ryood/8thMFB/IMG_20201001_090948.jpg

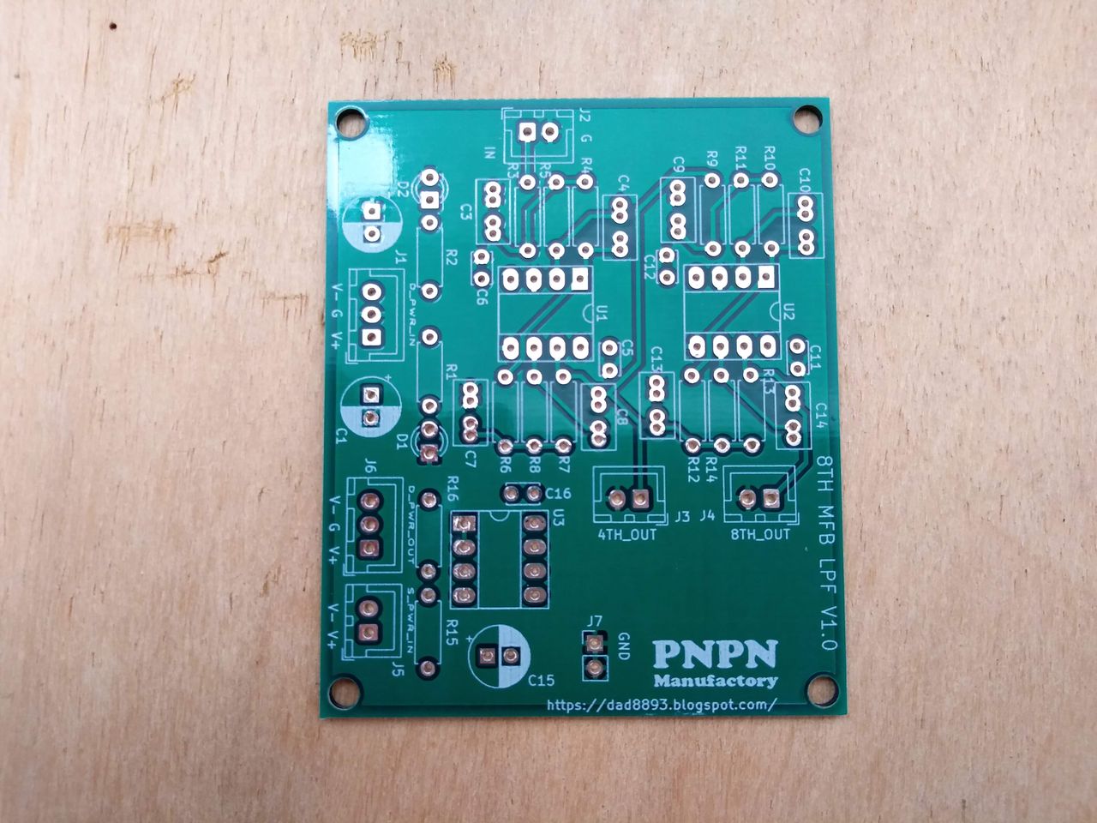
IMG_20201001_090948.jpg
