ryood/8thMFB/IMG_20201005_175604.jpg

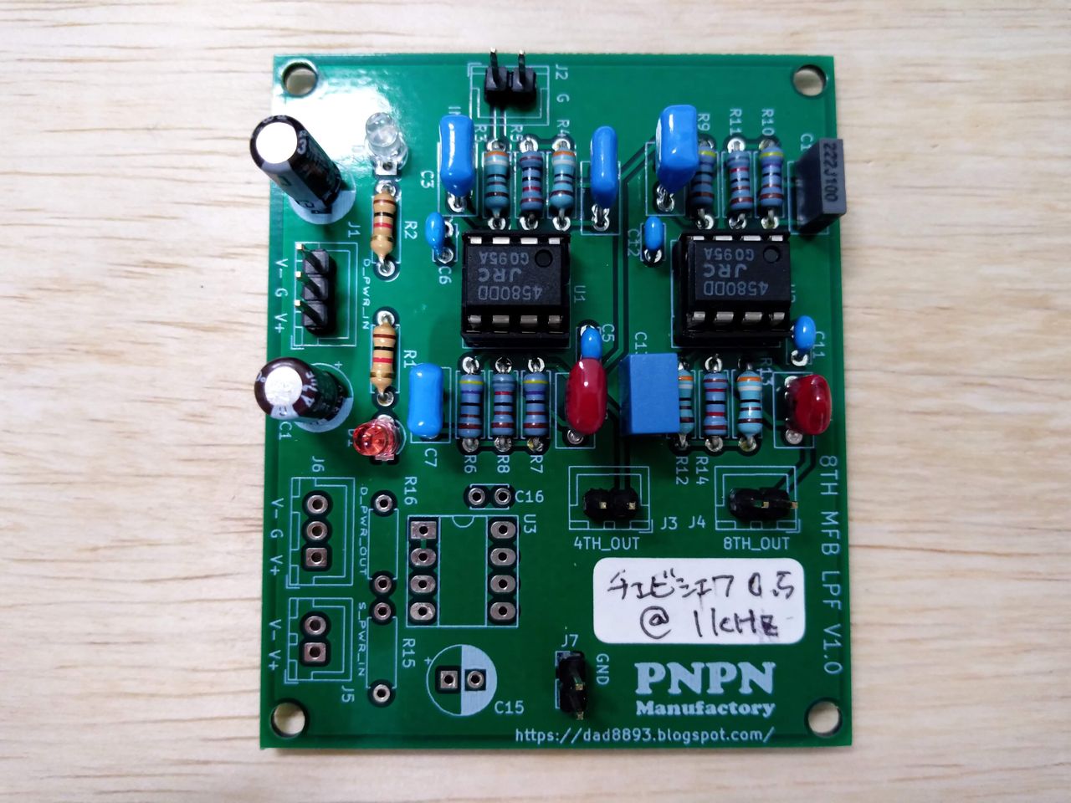
IMG_20201005_175604.jpg
