ryood/8thMFB/8thBesselLPF_MFB.PNG

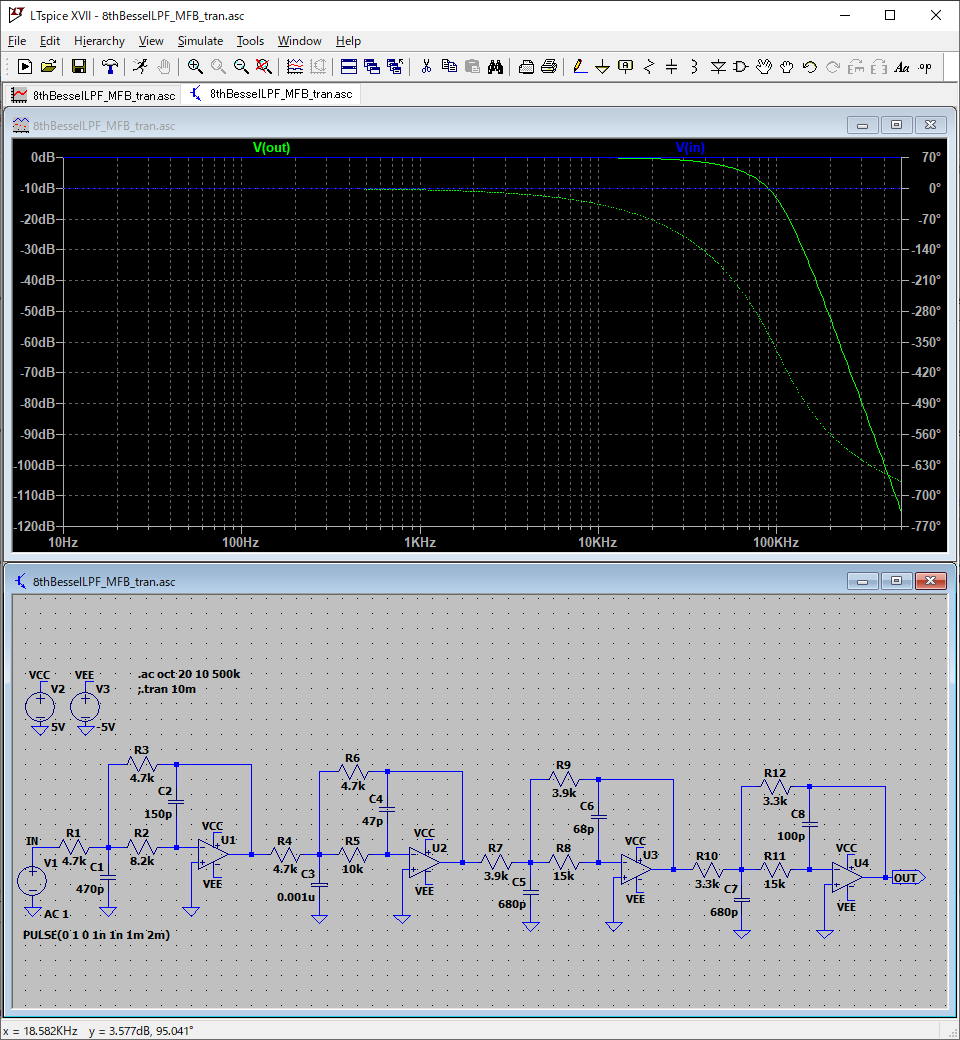
8thBesselLPF_MFB.PNG
