ryood/8thMFB/Bessel_1kHz_ac.png

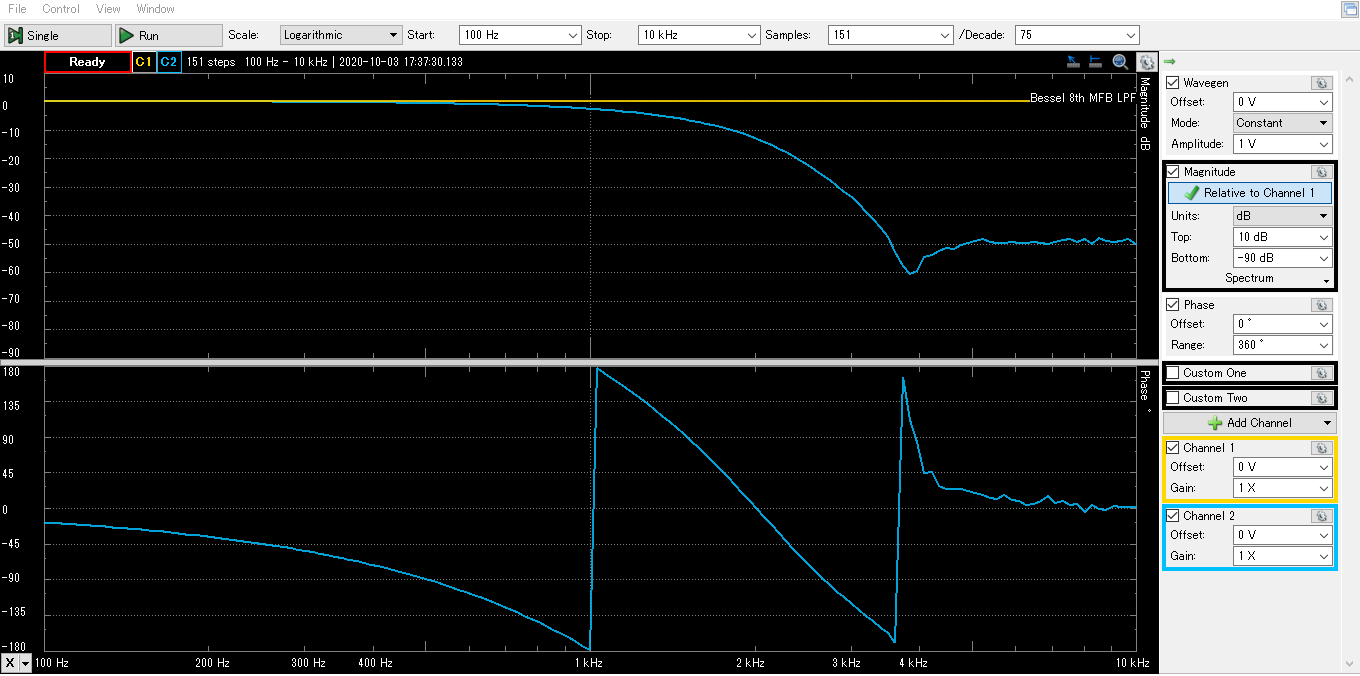
Bessel_1kHz_ac.png
