ryood/8thMFB/Bessel_1kHz_cutoff.png

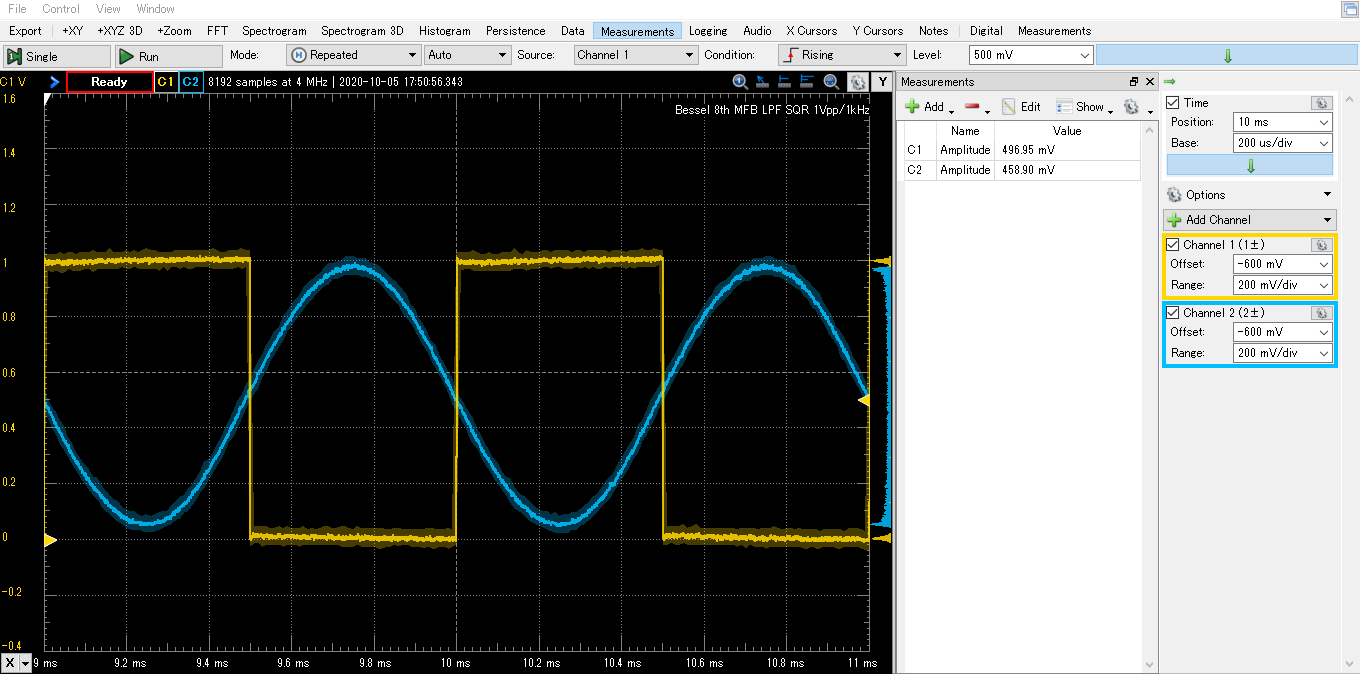
Bessel_1kHz_cutoff.png
