ryood/8thMFB/Bessel_1kHz_saw.png

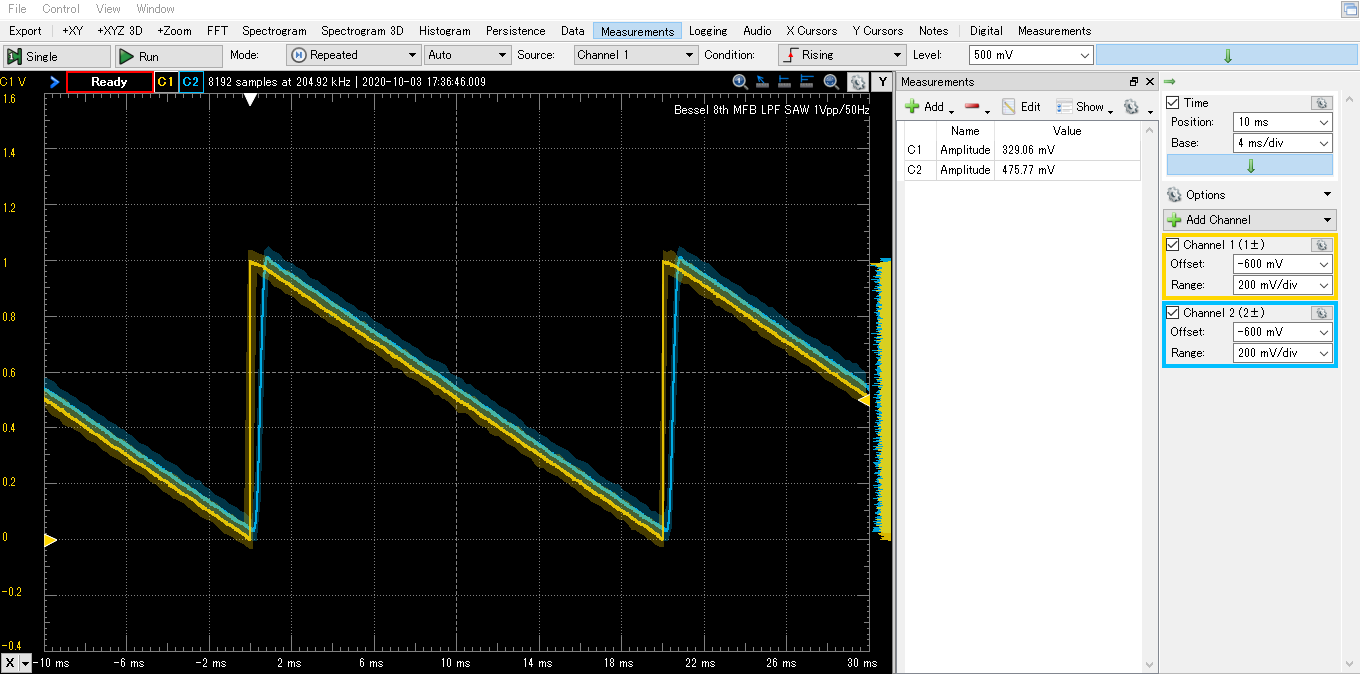
Bessel_1kHz_saw.png
