ryood/8thMFB/Butterworth_1kHz_ac.png

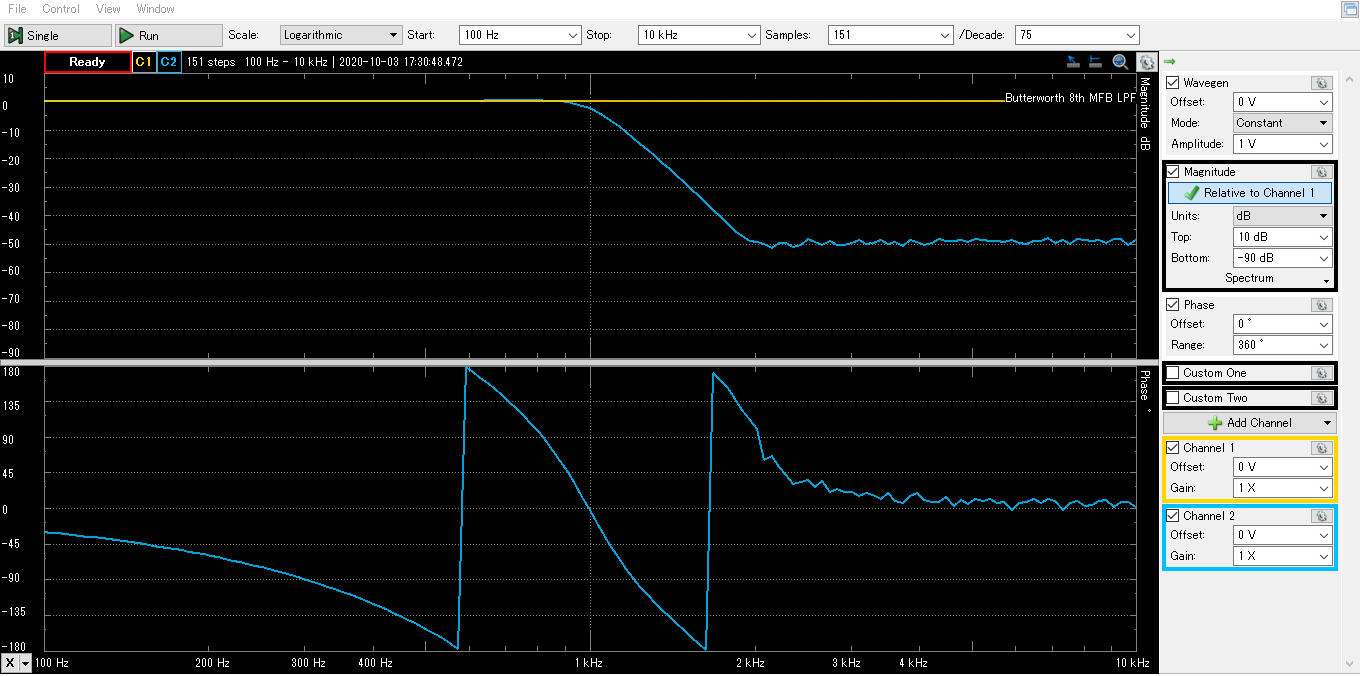
Butterworth_1kHz_ac.png
