ryood/8thMFB/Butterworth_1kHz_cutoff.png

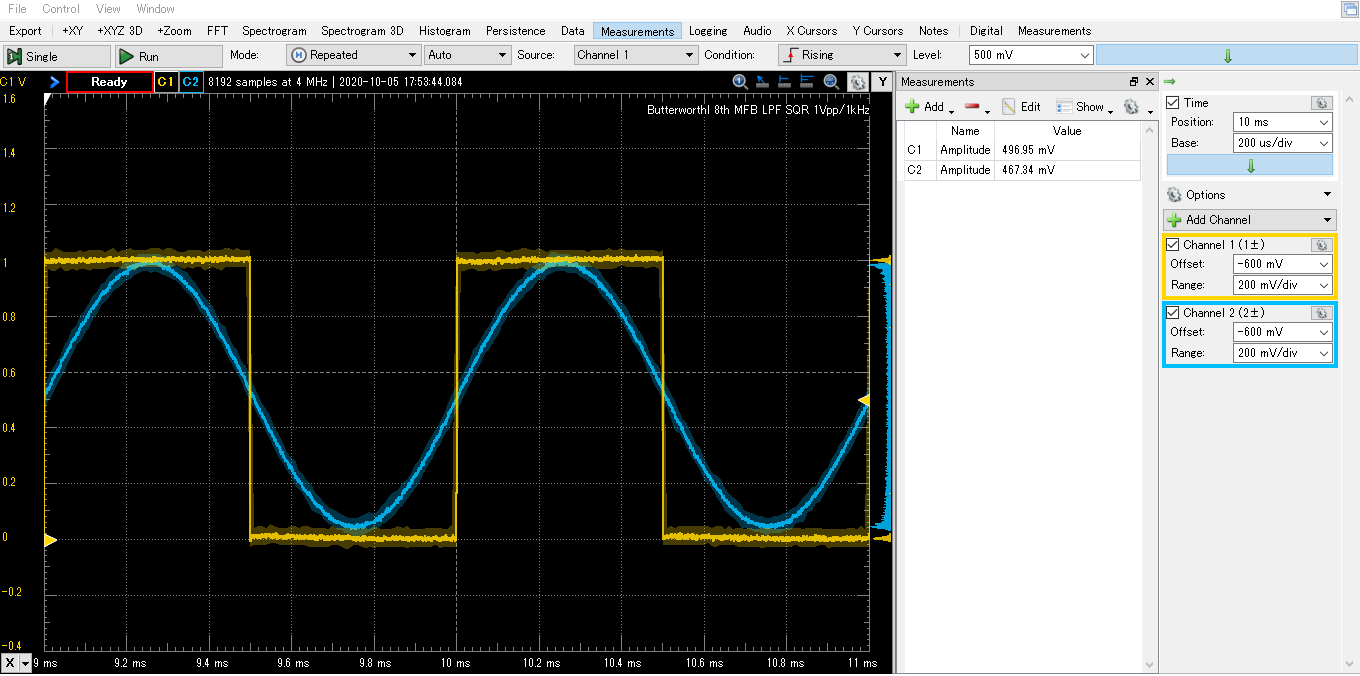
Butterworth_1kHz_cutoff.png
