ryood/8thMFB/Chebyshev_0_5dB_1kHz_ac.png

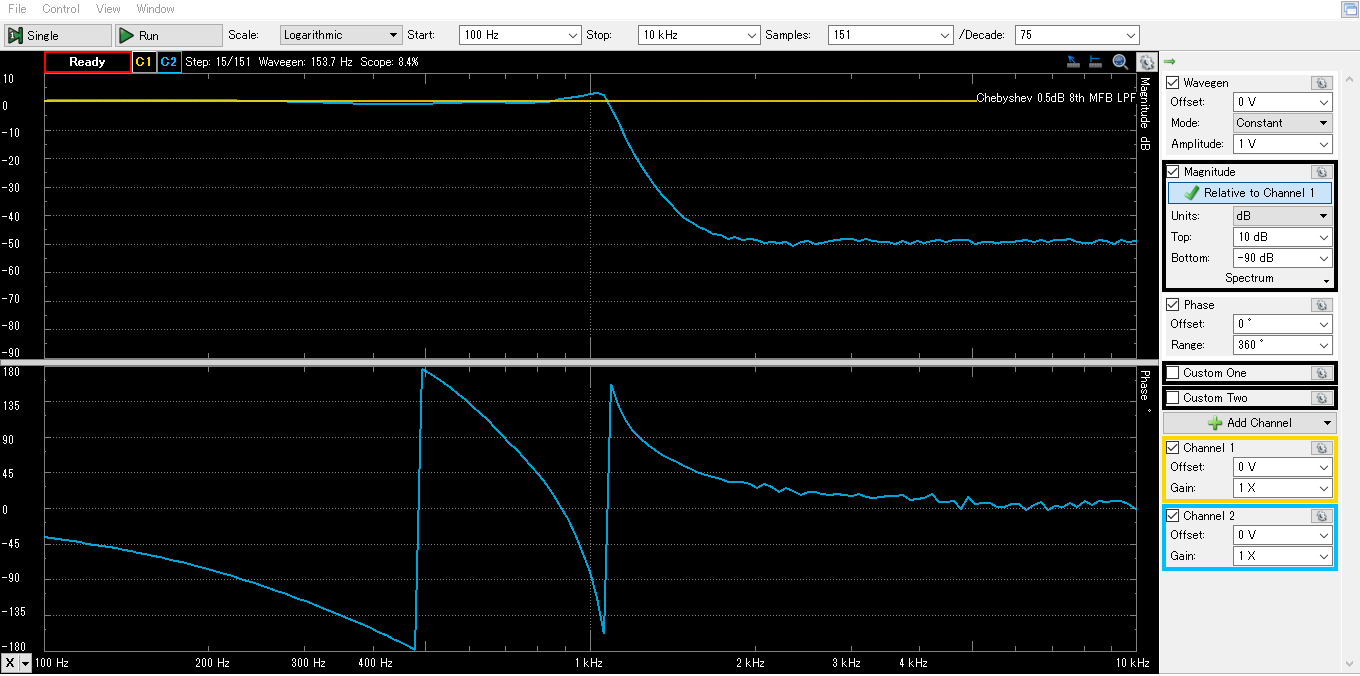
Chebyshev_0_5dB_1kHz_ac.png
