ryood/8thMFB/General_8th_MFB_LPF_sch_Draft.jpg

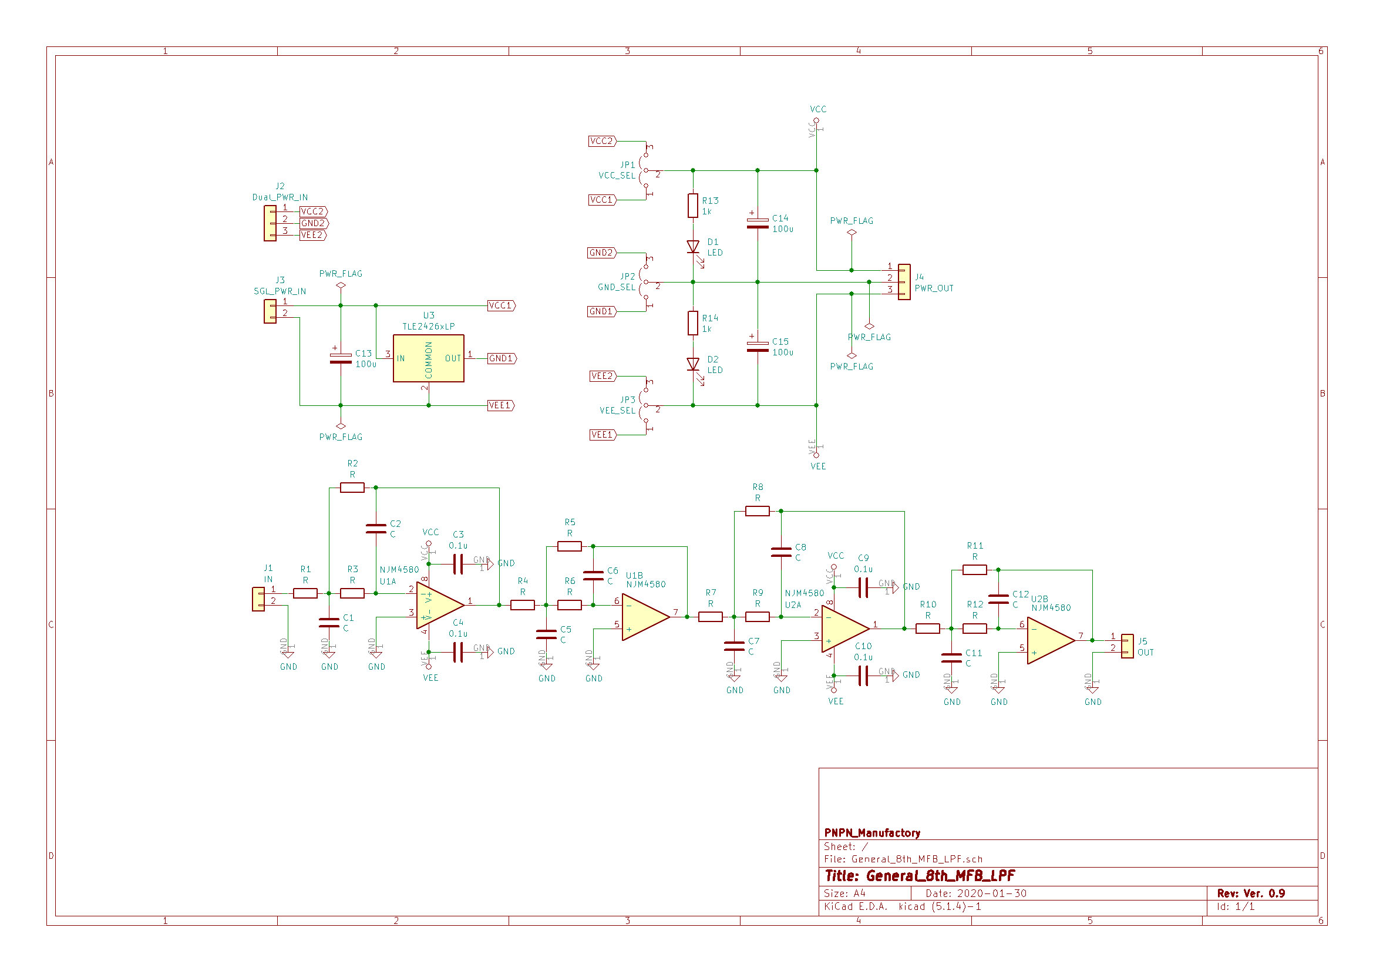
General_8th_MFB_LPF_sch_Draft.jpg
