ryood/8thMFB/IMG_20201001_091002.jpg

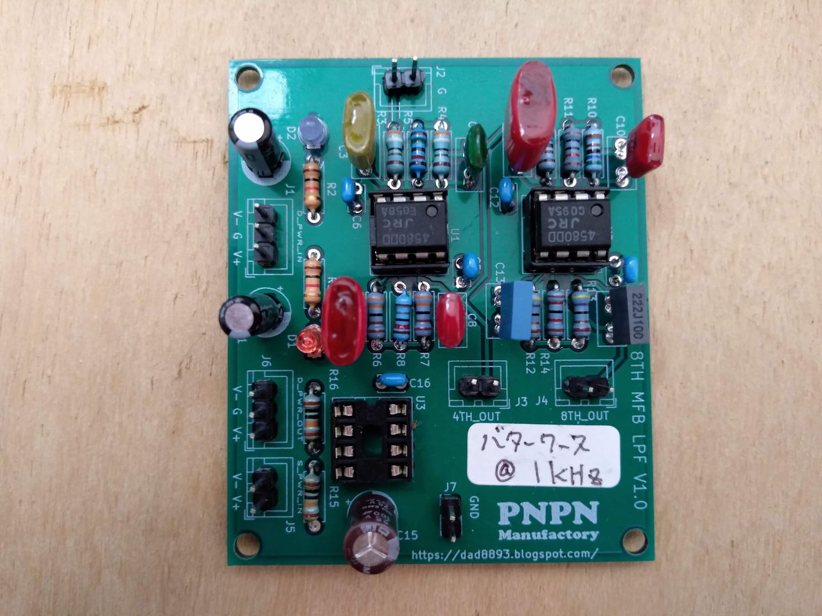
IMG_20201001_091002.jpg
