ryood/8thMFB/IMG_20201001_091025.jpg

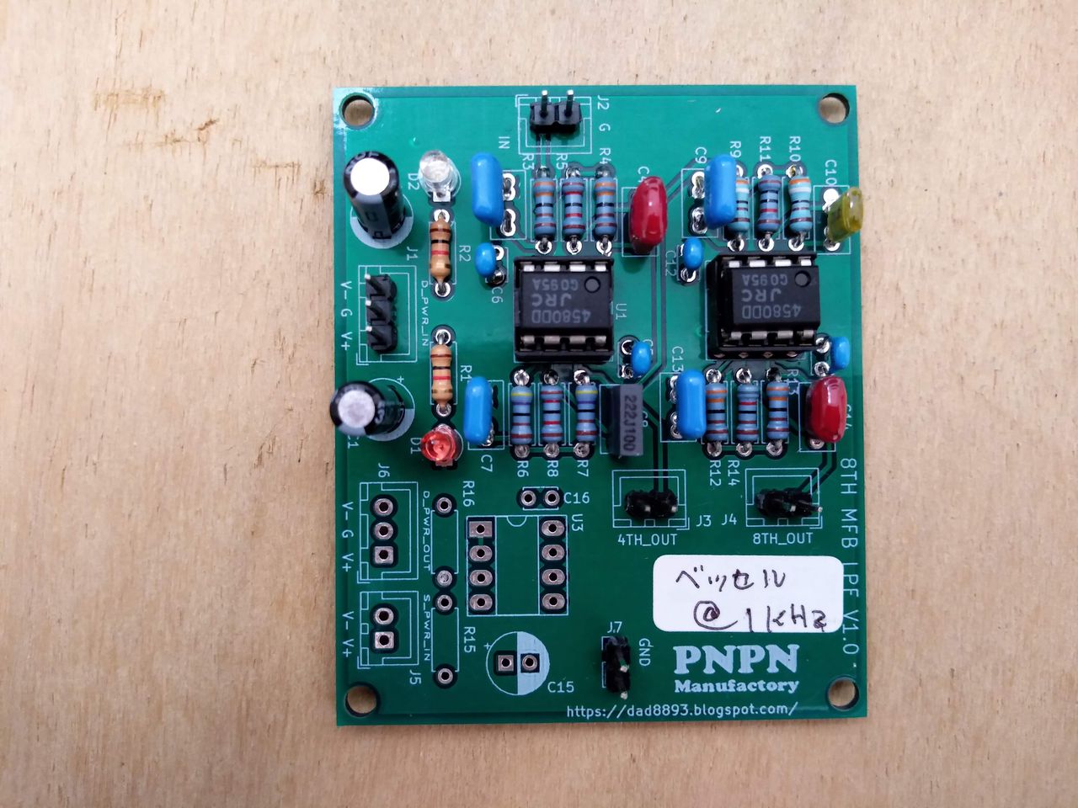
IMG_20201001_091025.jpg
