ryood/8thMFB/KiCAD/General_8th_MFB_LPF_brd.png

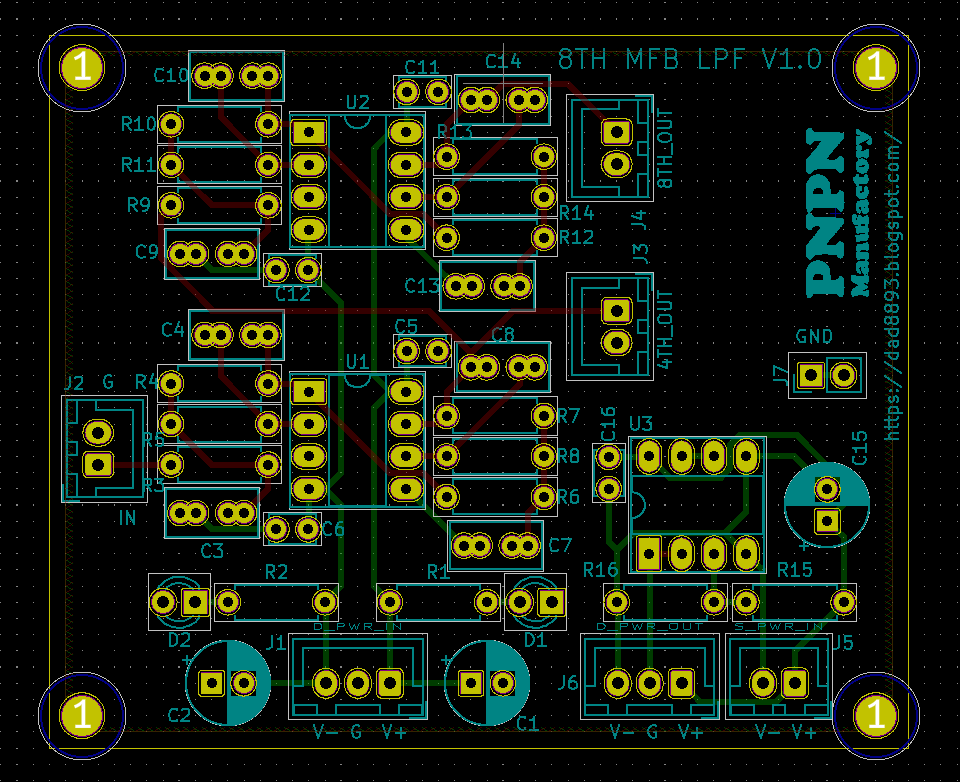
KiCAD/General_8th_MFB_LPF_brd.png
