ryood/8thMFB/spice/1kHz/8th_MFB_LPF_Bessel_1kHz_sch.png

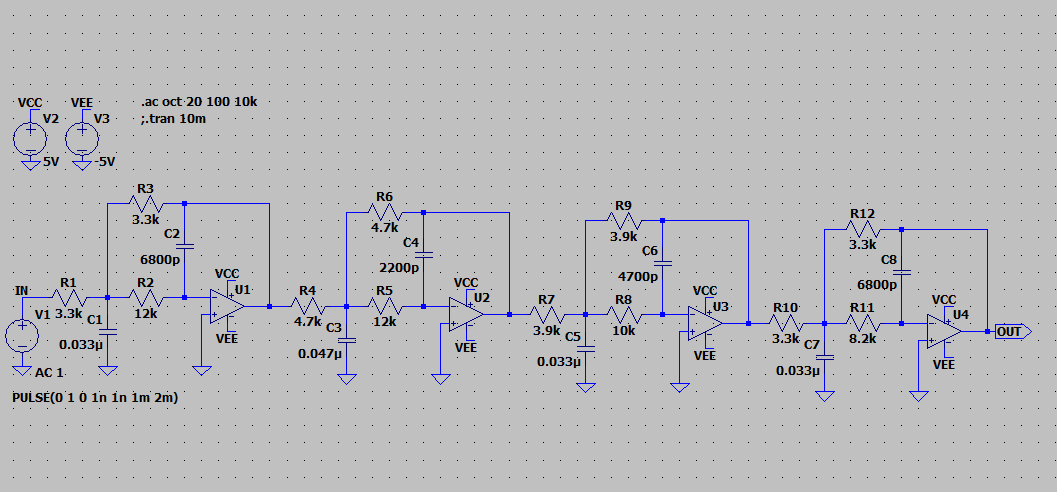
spice/1kHz/8th_MFB_LPF_Bessel_1kHz_sch.png
