ryood/8thMFB/spice/1kHz/8th_MFB_LPF_Chebyshev_0_5dB_1kHz_ac.png

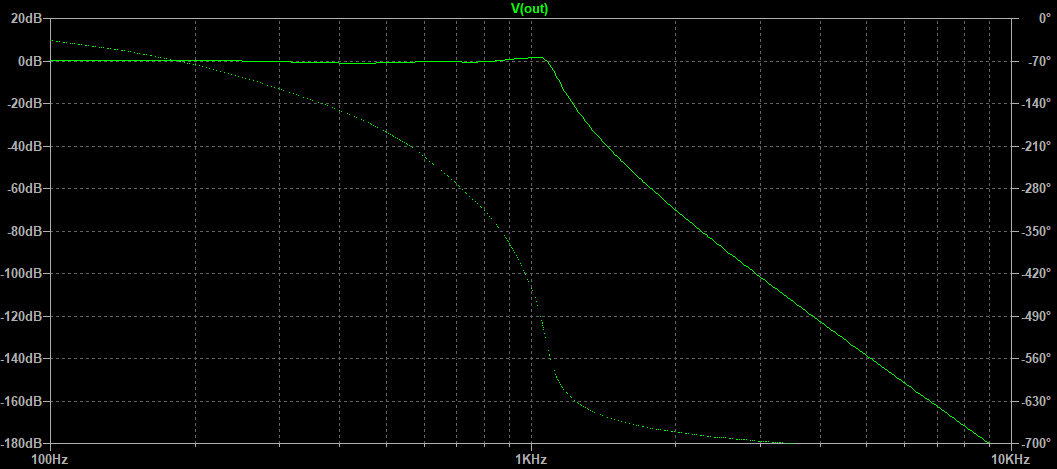
spice/1kHz/8th_MFB_LPF_Chebyshev_0_5dB_1kHz_ac.png
