ryood/8thMFB/Bessel_1kHz_step.png

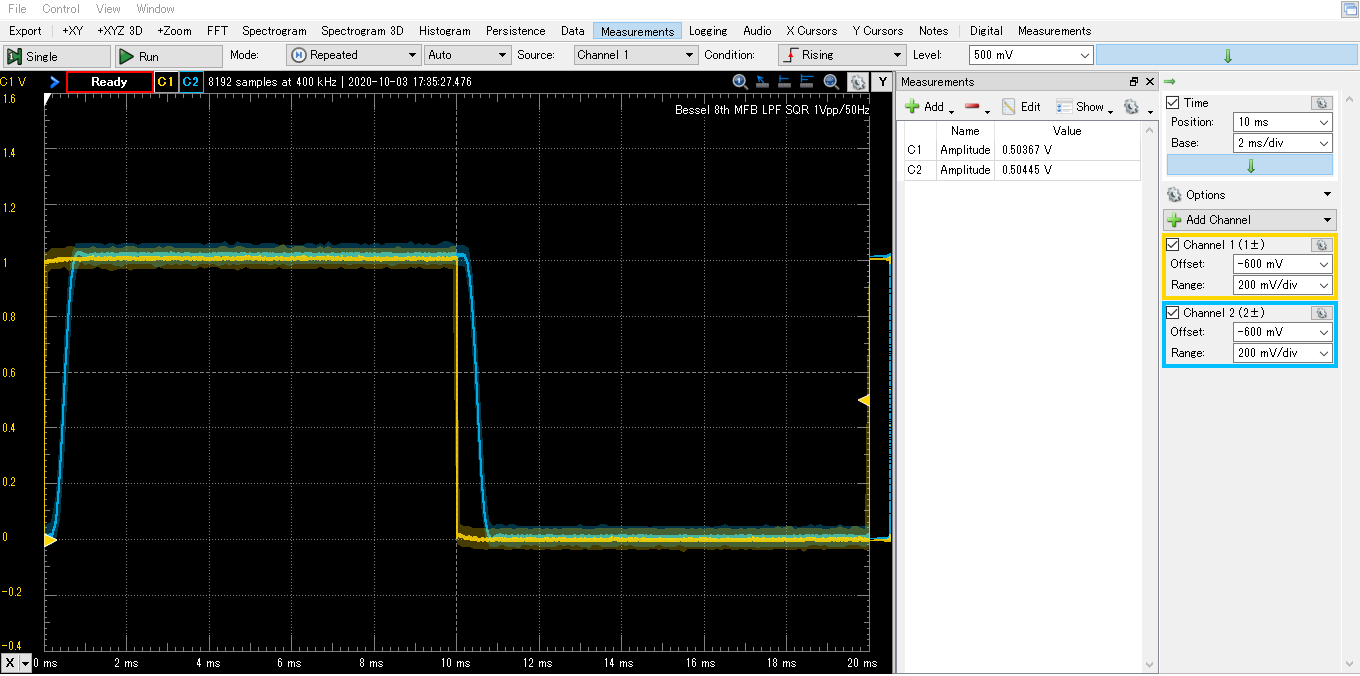
Bessel_1kHz_step.png
