ryood/8thMFB/spice/1kHz/8th_MFB_LPF_Bessel_1kHz_step.png

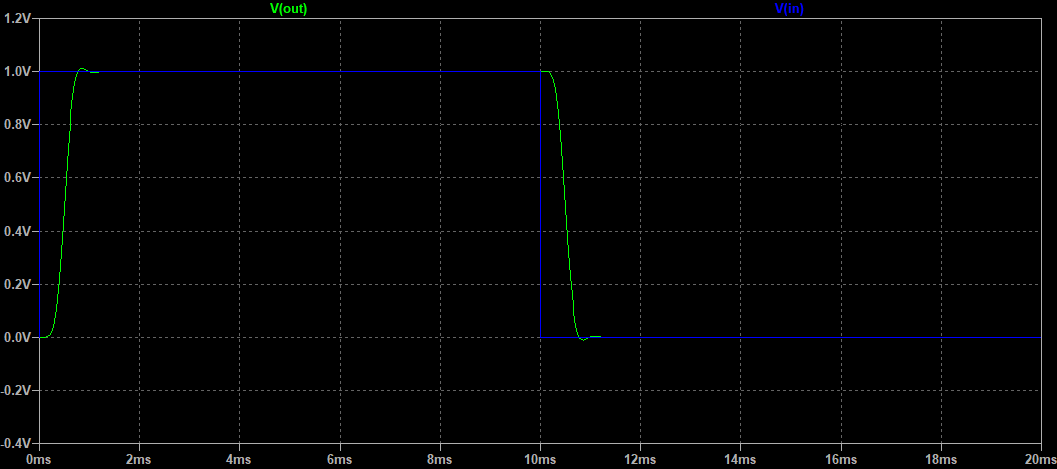
spice/1kHz/8th_MFB_LPF_Bessel_1kHz_step.png
