ryood/8thMFB/spice/Test/8th_bessel_48k_ac.png

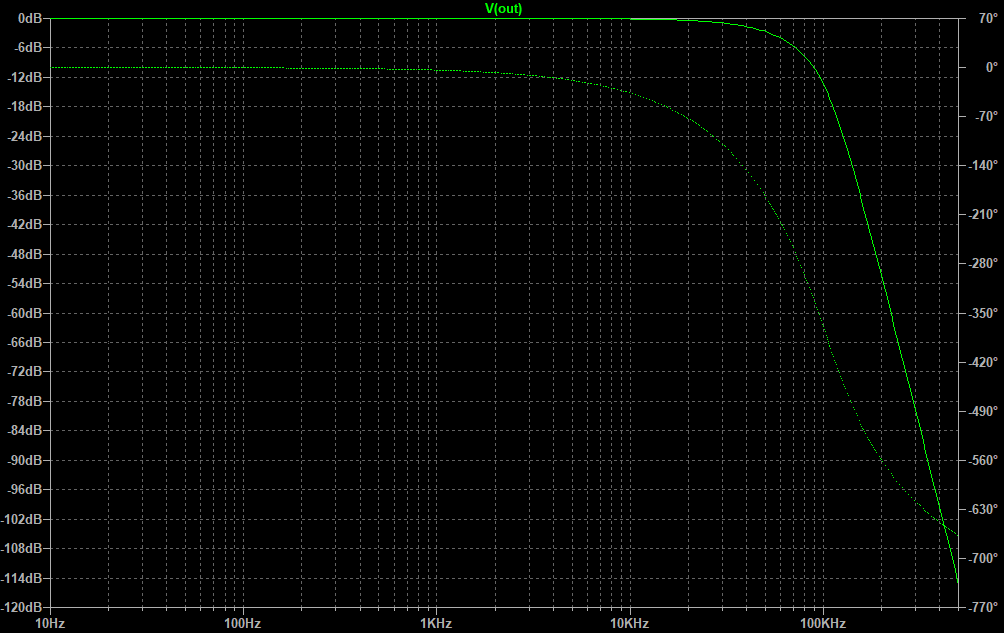
spice/Test/8th_bessel_48k_ac.png
