ryood/8thMFB/spice/1kHz/8th_MFB_LPF_ButterWorth_1kHz_step.asc

C1: cap; 0.047µ
C2: cap; 0.01µ
C3: cap; 0.068µ
C4: cap; 6800p
C5: cap; 0.068µ
C6: cap; 6800p
C7: cap; 0.22µ
C8: cap; 2200p
R1: res; 3.9k
R2: res; 15k
R3: res; 3.9k
R4: res; 3.3k
R5: res; 18k
R6: res; 3.3k
R7: res; 5.6k
R8: res; 10k
R9: res; 5.6k
R10: res; 4.7k
R11: res; 12k
R12: res; 4.7k
U1: UniversalOpamp2
U2: UniversalOpamp2
U3: UniversalOpamp2
U4: UniversalOpamp2
V1: voltage; PULSE(0 1 0 1n 1n 10m 20m); AC 1
V2: voltage; 5V
V3: voltage; -5V
Named nets: VCC, VEE, 0, OUT, IN
;.ac oct 20 10 500k
.tran 20m
