ryood/8thMFB/spice/1kHz/8th_MFB_LPF_Chebyshev_0_5dB_1kHz_step.asc

C1: cap; 0.22µ
C2: cap; 0.033µ
C3: cap; 0.22µ
C4: cap; 6800p
C5: cap; 0.33µ
C6: cap; 2200p
C7: cap; 1µ
C8: cap; 470p
R1: res; 3.9k
R2: res; 10k
R3: res; 3.9k
R4: res; 4.7k
R5: res; 8.2k
R6: res; 4.7k
R7: res; 4.7k
R8: res; 8.2k
R9: res; 4.7k
R10: res; 3.9k
R11: res; 12k
R12: res; 3.9k
U1: UniversalOpamp2
U2: UniversalOpamp2
U3: UniversalOpamp2
U4: UniversalOpamp2
V1: voltage; PULSE(0 1 0 1n 1n 10m 20m); AC 1
V2: voltage; 5V
V3: voltage; -5V
Named nets: VCC, VEE, 0, OUT, IN
;.ac oct 20 10 500k
.tran 20m
