ryood/8thMFB/spice/Test/8thBesselLPF_MFB_ac.asc

C1: cap; 470p
C2: cap; 150p
C3: cap; 0.001u
C4: cap; 47p
C5: cap; 680p
C6: cap; 68p
C7: cap; 680p
C8: cap; 100p
R1: res; 4.7k
R2: res; 8.2k
R3: res; 4.7k
R4: res; 4.7k
R5: res; 10k
R6: res; 4.7k
R7: res; 3.9k
R8: res; 15k
R9: res; 3.9k
R10: res; 3.3k
R11: res; 15k
R12: res; 3.3k
U1: UniversalOpamp2
U2: UniversalOpamp2
U3: UniversalOpamp2
U4: UniversalOpamp2
V1: voltage; PULSE(0 1 0 1n 1n 1m 2m); AC 1
V2: voltage; 5V
V3: voltage; -5V
Named nets: VCC, VEE, 0, OUT, IN
.ac oct 20 10 500k
;.tran 10m
