ryood/8thMFB/spice/Test/8thButterWorthLPF_MFB.asc

C1: cap; 470p
C2: cap; 100p
C3: cap; 680p
C4: cap; 100p
C5: cap; 680p
C6: cap; 68p
C7: cap; 0.0022u
C8: cap; 22p
R1: res; 3.9k
R2: res; 15k
R3: res; 3.9k
R4: res; 3.3k
R5: res; 12k
R6: res; 3.3k
R7: res; 5.6k
R8: res; 10k
R9: res; 5.6k
R10: res; 4.7k
R11: res; 12k
R12: res; 4.7k
U1: UniversalOpamp2
U2: UniversalOpamp2
U3: UniversalOpamp2
U4: UniversalOpamp2
V1: voltage; PULSE(-0.5 0.5 0 100u 0 0 100u); AC 1
V2: voltage; 5V
V3: voltage; -5V
Named nets: VCC, VEE, 0, OUT, IN
;ac oct 20 10 500k
.tran 300us
