ryood/8thMFB/spice/Test/9thBesselLPF_MFB.asc

C1: cap; 470p
C2: cap; 150p
C3: cap; 680p
C4: cap; 100p
C5: cap; 680p
C6: cap; 100p
C7: cap; 0.001u
C8: cap; 47p
C9: cap; 0.01u
R1: res; 4.7k
R2: res; 8.2k
R3: res; 4.7k
R4: res; 3.3k
R5: res; 12k
R6: res; 3.3k
R7: res; 3.9k
R8: res; 12k
R9: res; 3.9k
R10: res; 4.7k
R11: res; 8.2k
R12: res; 4.7k
R13: res; 180
U1: UniversalOpamp2
U2: UniversalOpamp2
U3: UniversalOpamp2
U4: UniversalOpamp2
U5: UniversalOpamp2
V1: voltage; PULSE(-0.5 0.5 0 100u 1n 0 100u); AC 1
V2: voltage; 5V
V3: voltage; -5V
Named nets: VCC, VEE, 0, OUT, IN
.ac oct 20 10 500k
;.tran 300u
