ryood/8thMFB/spice/Test/PCM5102A_FG_RLC_4thLPF.asc

C1: cap; 0.033uF
C2: cap; 0.022uF
C3: cap; 8200pF
L1: ind; 4.7uH
L2: ind; 68uH
L3: ind; 2.2uH
R1: res; 50
R2: res; 50
V1: voltage; PULSE(-0.5 0.5 0 100u 0 0 100u); AC 1
Named nets: 0, OUT
.ac oct 20 10 1Meg
;tran 0 10m 9.7m
