ryood/8thMFB/(list of files, drawings)

Other design files:
fritzing/8th_MFB.fzz
