ryood/8thMFB/KiCAD/General_8th_MFB_LPF/General_8th_MFB_LPF.kicad_pcb

## KiCad design KiCAD/General_8th_MFB_LPF/General_8th_MFB_LPF.kicad_pcb (2020-10-05)

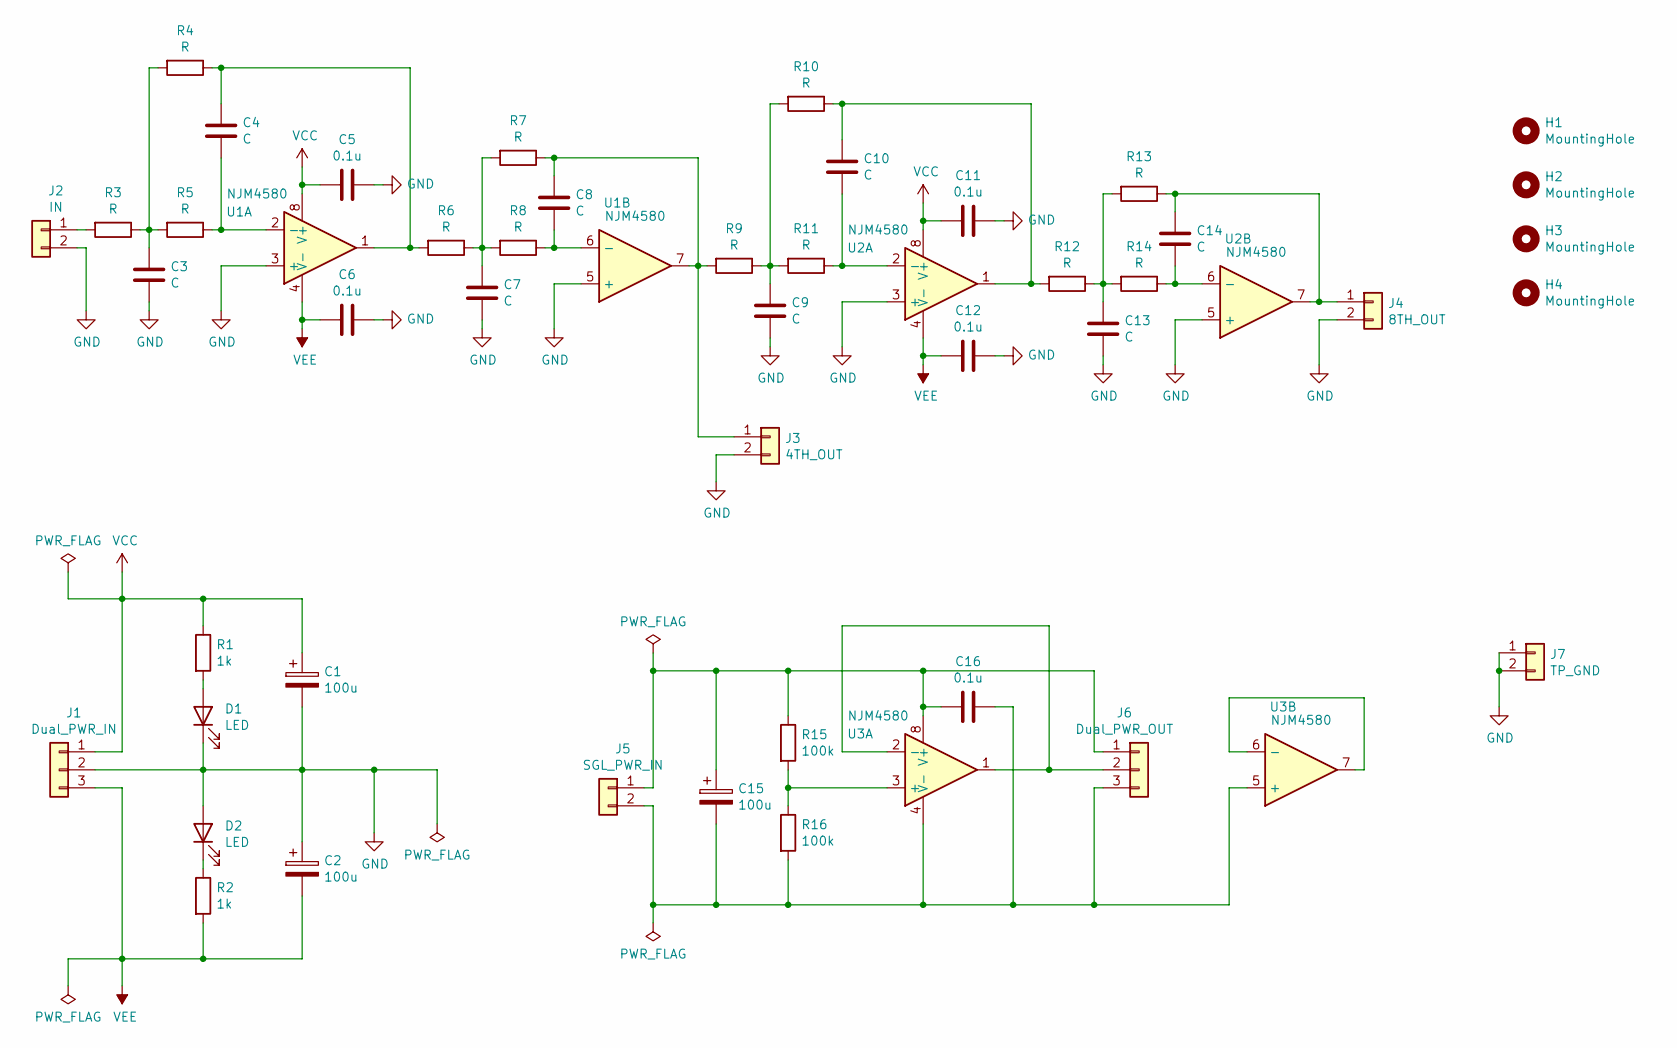
[picture p26: schematic General_8th_MFB_LPF.sch]

Parts:
C1, C2, C15: 100u; CP_Radial_D6.3mm_P2.50mm
C3, C4, C7, C8, C9, C10, C13, C14: C; C_Rect_L7.0mm_W3.5mm_P2.50mm_P5.00mm
C5, C6, C11, C12, C16: 0.1u; C_Disc_D3.4mm_W2.1mm_P2.50mm
D1, D2: LED; LED_D3.0mm
H1, H2, H3, H4: MountingHole; MountingHole_3.2mm_M3
J1: Dual_PWR_IN; JST_XH_B3B-XH-A_1x03_P2.50mm_Vertical
J2: IN; JST_XH_B2B-XH-A_1x02_P2.50mm_Vertical
J3: 4TH_OUT; JST_XH_B2B-XH-A_1x02_P2.50mm_Vertical
J4: 8TH_OUT; JST_XH_B2B-XH-A_1x02_P2.50mm_Vertical
J5: SGL_PWR_IN; JST_XH_B2B-XH-A_1x02_P2.50mm_Vertical
J6: Dual_PWR_OUT; JST_XH_B3B-XH-A_1x03_P2.50mm_Vertical
J7: TP_GND; PinHeader_1x02_P2.54mm_Vertical
R1, R2: 1k; R_Axial_DIN0207_L6.3mm_D2.5mm_P7.62mm_Horizontal
R3, R4, R5, R6, R7, R8, R9, R10, R11, R12, R13, R14: R; R_Axial_DIN0207_L6.3mm_D2.5mm_P7.62mm_Horizontal
R15, R16: 100k; R_Axial_DIN0207_L6.3mm_D2.5mm_P7.62mm_Horizontal
U1, U2, U3: NJM4580; DIP-8_W7.62mm_Socket_LongPads

Connections:
GND: C1.2, C2.1, C3.2, C5.1, C6.1, C7.2, C9.2, C11.1, C12.1, C13.2, D1.1 (K), D2.2 (A), J1.2, J2.2, J3.2, J4.2, J7.1, J7.2, U1.3 (+), U1.5 (+), U2.3 (+), U2.5 (+)
unnamed: C3.1, R3.1, R4.2, R5.2
unnamed: C4.1, R4.1, R6.2, U1.1
unnamed: C4.2, R5.1, U1.2 (-)
unnamed: C7.1, R6.1, R7.2, R8.2
unnamed: C8.1, J3.1, R7.1, R9.2, U1.7
unnamed: C8.2, R8.1, U1.6 (-)
unnamed: C9.1, R9.1, R10.2, R11.2
unnamed: C10.1, R10.1, R12.2, U2.1
unnamed: C10.2, R11.1, U2.2 (-)
unnamed: C13.1, R12.1, R13.2, R14.2
unnamed: C14.1, J4.1, R13.1, U2.7
unnamed: C14.2, R14.1, U2.6 (-)
unnamed: C15.1, C16.2, J5.1, J6.1, R15.1, U3.8 (V+)
unnamed: C15.2, C16.1, J5.2, J6.3, R16.2, U3.4 (V-), U3.5 (+)
unnamed: D1.2 (A), R1.2
unnamed: D2.1 (K), R2.1
unnamed: J2.1, R3.2
unnamed: J6.2, U3.1, U3.2 (-)
unnamed: R15.2, R16.1, U3.3 (+)
unnamed: U3.6 (-), U3.7
VCC: C1.1, C5.2, C11.2, J1.1, R1.1, U1.8 (V+), U2.8 (V+)
VEE: C2.2, C6.2, C12.2, J1.3, R2.2, U1.4 (V-), U2.4 (V-)

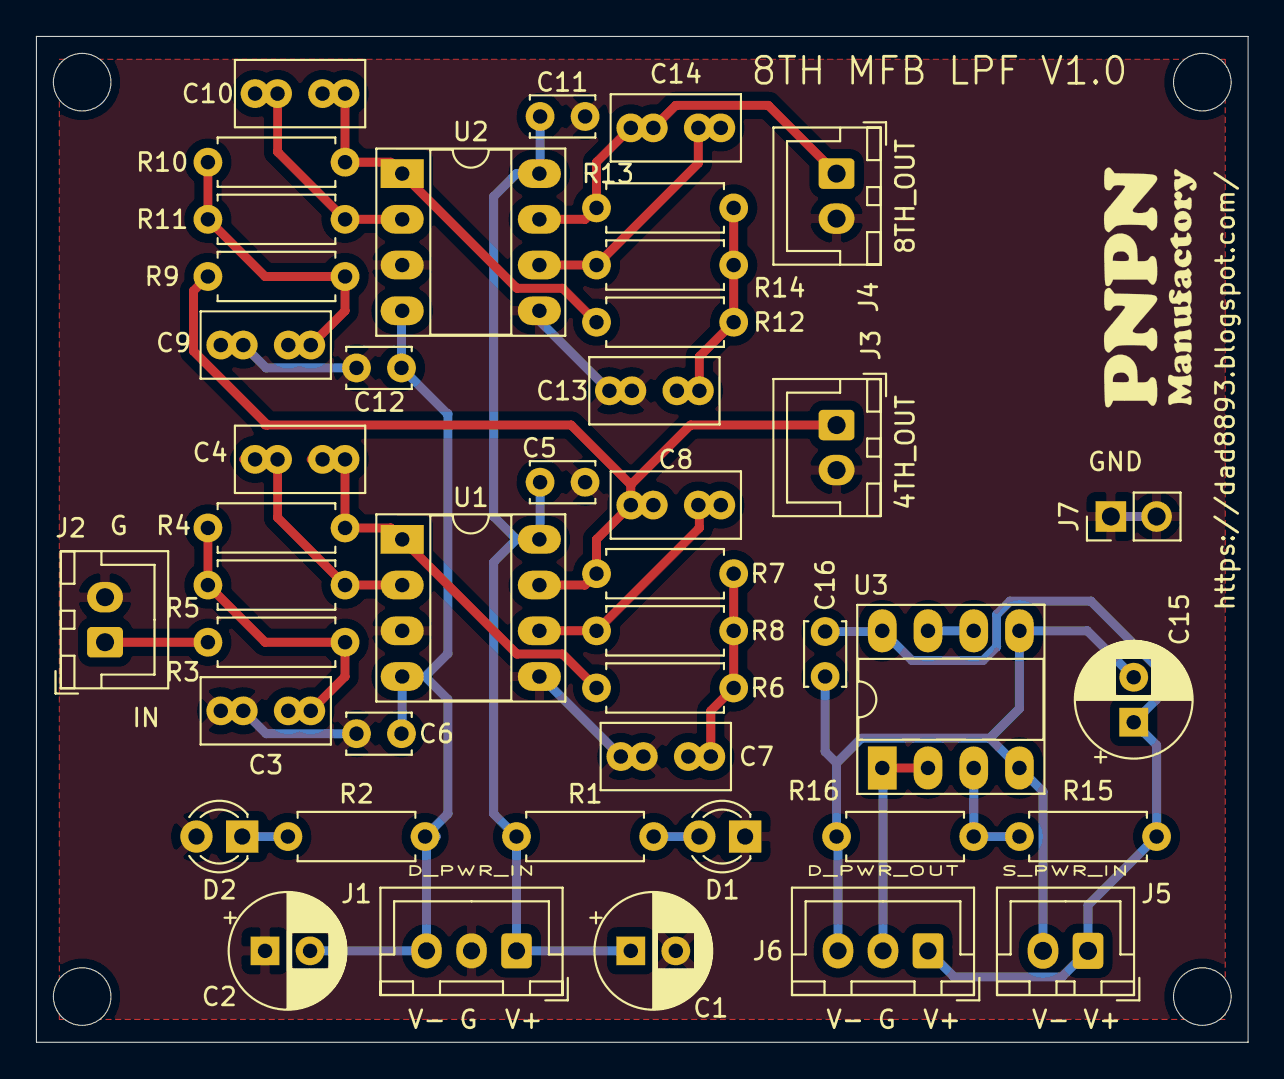
[picture p27: board General_8th_MFB_LPF.kicad_pcb from above]

Board: 2 copper layers, 67.3 x 55.9 mm, 48 parts (0 on the bottom side), 23 nets.
